ErikOostveen/PerfectBeat/images/20200609_163351.jpg

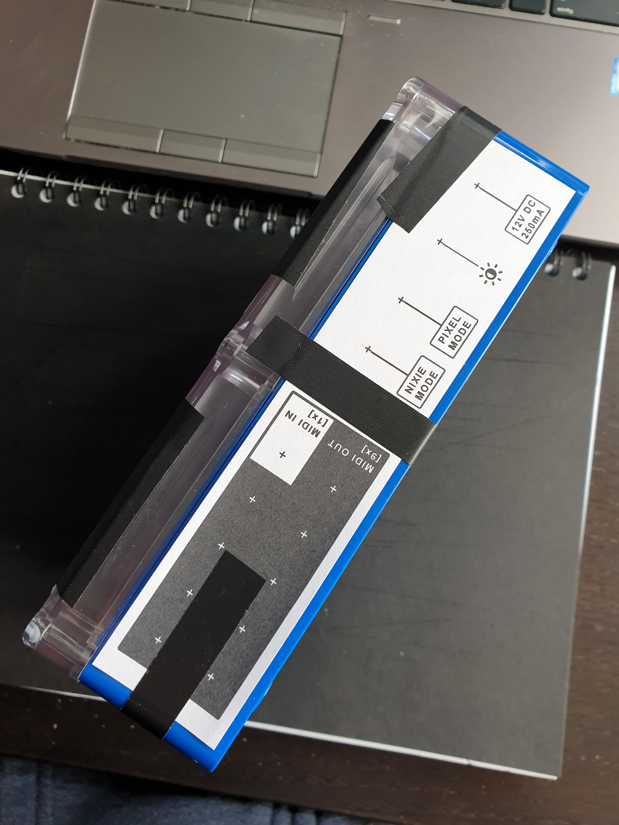
images/20200609_163351.jpg
