ErikOostveen/PerfectBeat/Diagram_PerfectBeat_V1.pdf

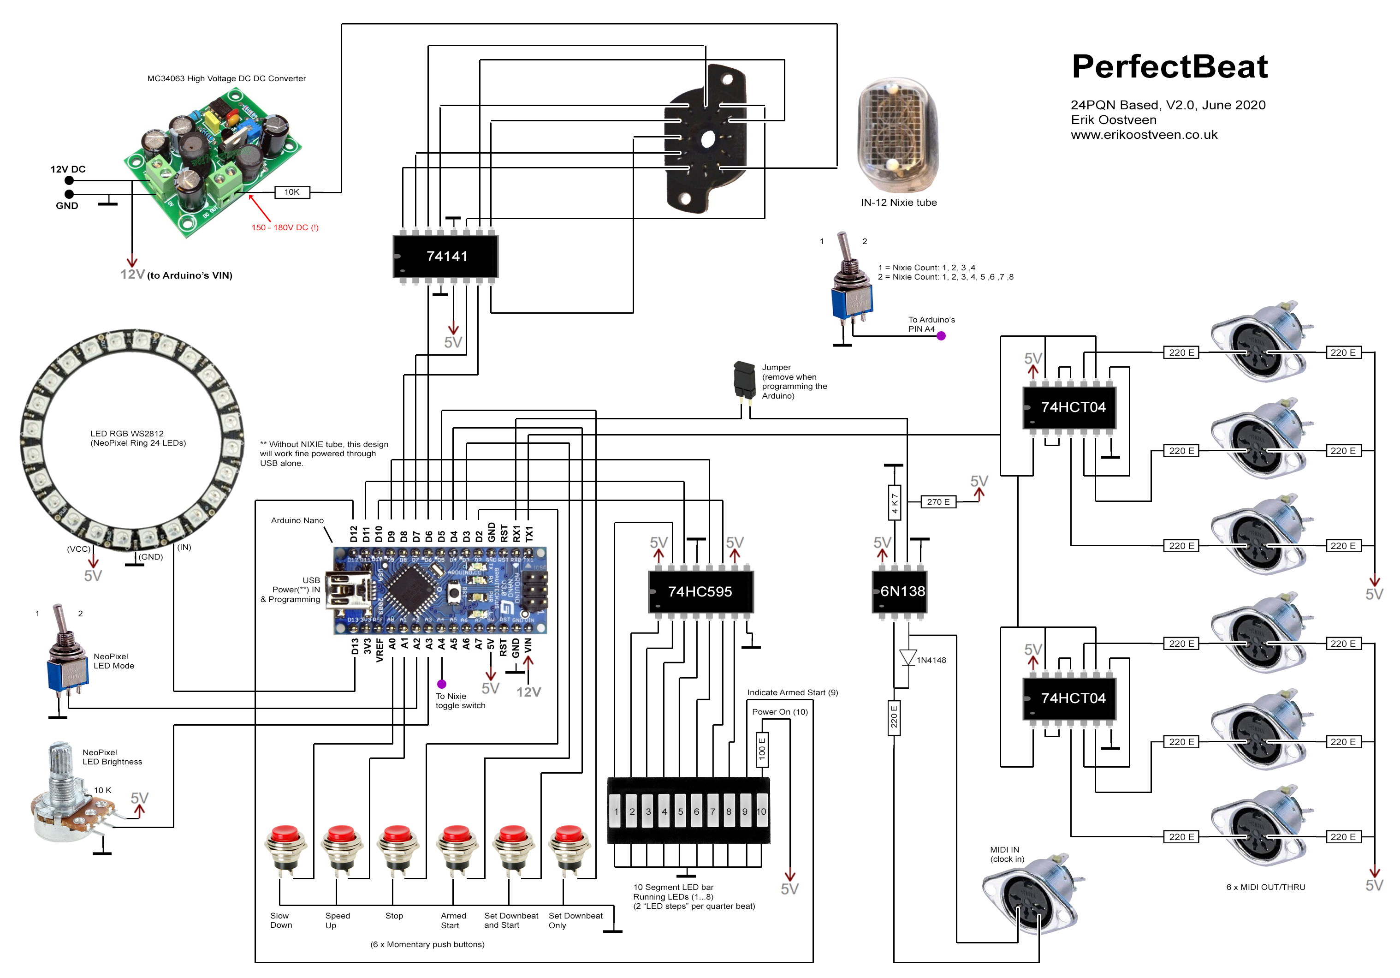
[picture p3: page 1]
