ErikOostveen/PerfectBeat/PerfectBeat_Front_V1_TEMPLATE_CUT_DRILL.pdf

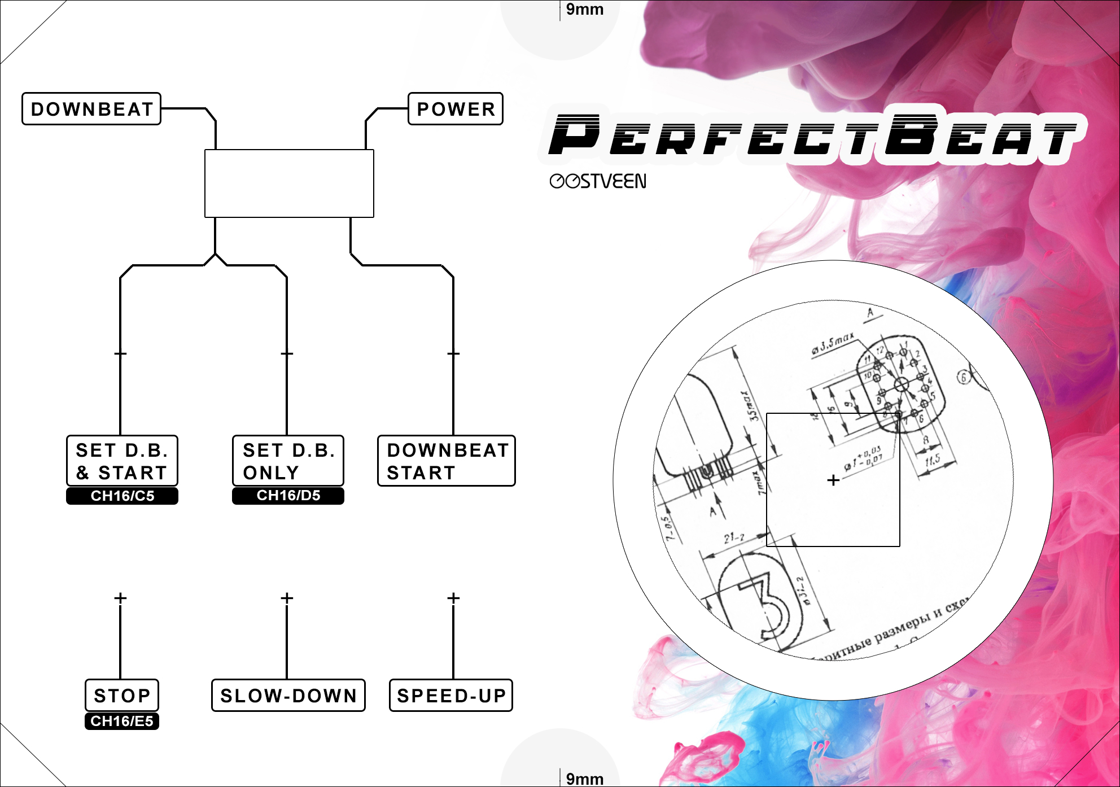
[picture p4: page 1]
