ErikOostveen/PerfectBeat/pcb/PerfectBeat_V1_PCB_Top_View.pdf

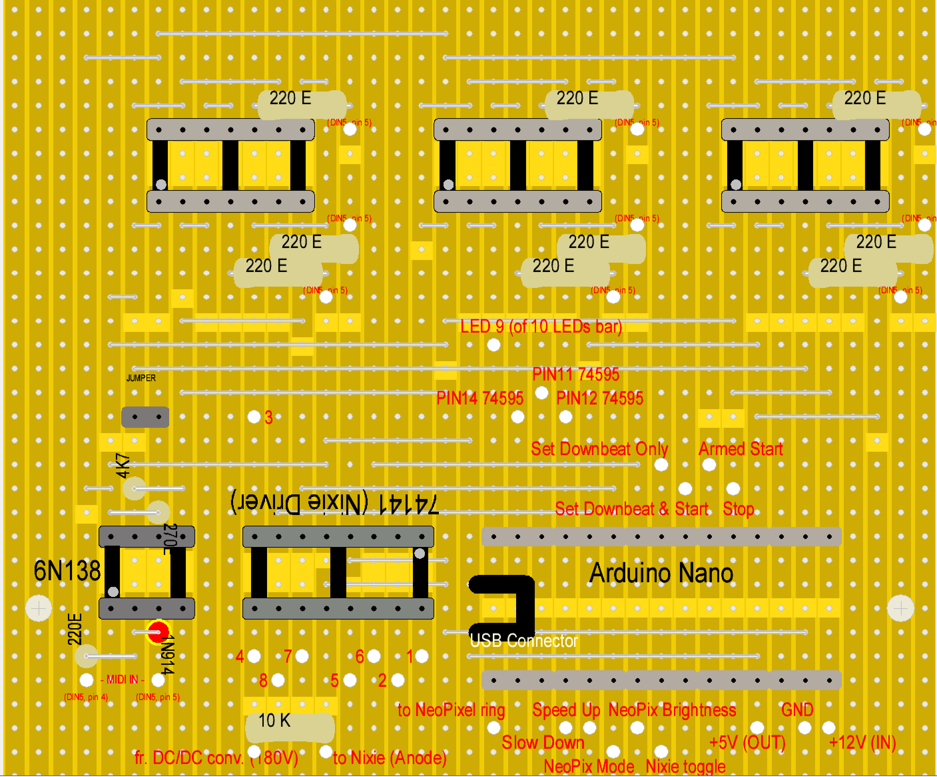
[picture p5: page 1]
