ErikOostveen/PerfectBeat/images/20200607_170726.jpg

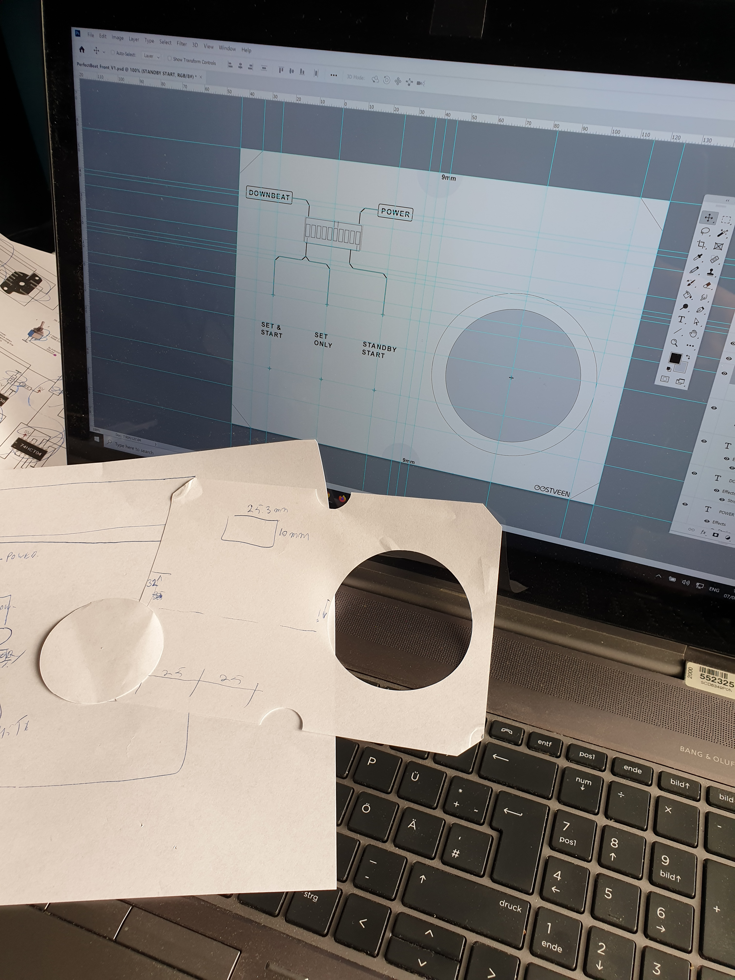
images/20200607_170726.jpg
