ErikOostveen/PerfectBeat/images/20200608_153944.jpg

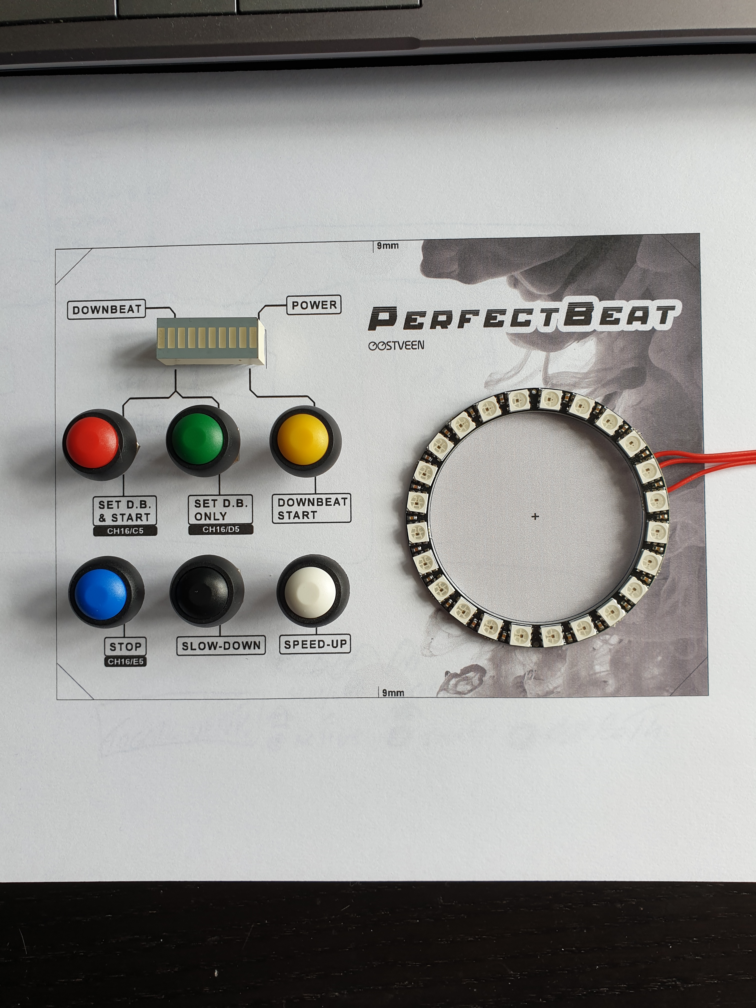
images/20200608_153944.jpg
