ErikOostveen/PerfectBeat/images/20200609_091026.jpg

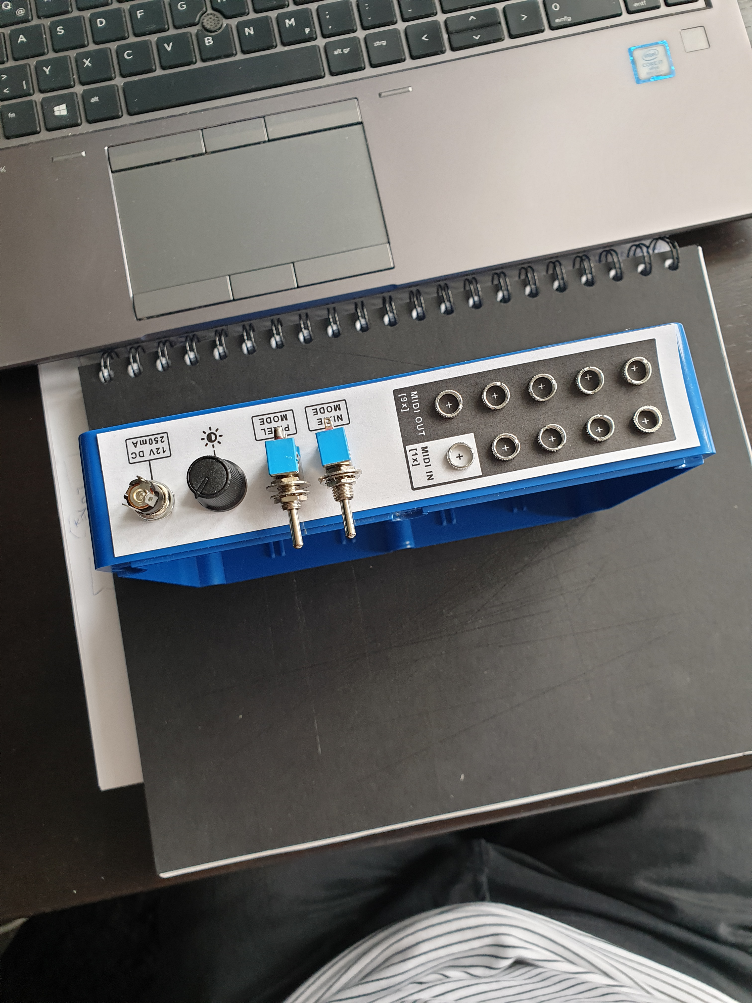
images/20200609_091026.jpg
