ErikOostveen/PerfectBeat/images/20200609_163342.jpg

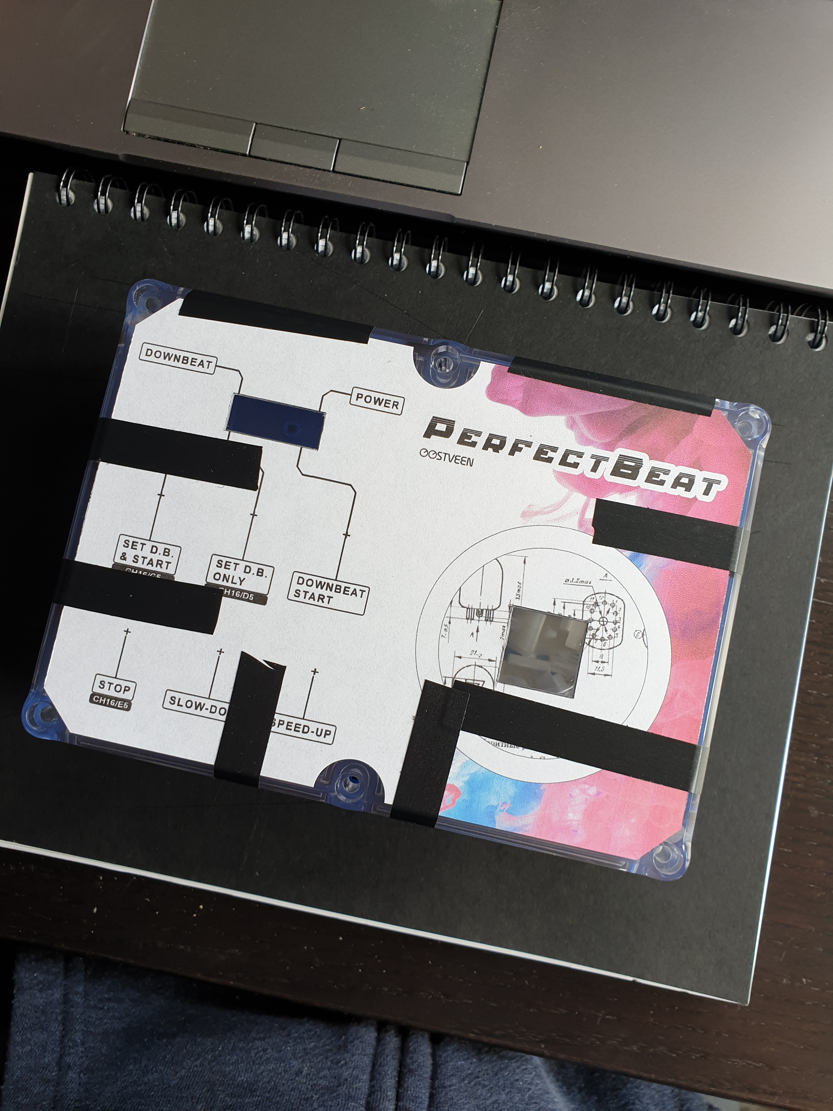
images/20200609_163342.jpg
