ErikOostveen/PerfectBeat/images/20200612_162909.jpg

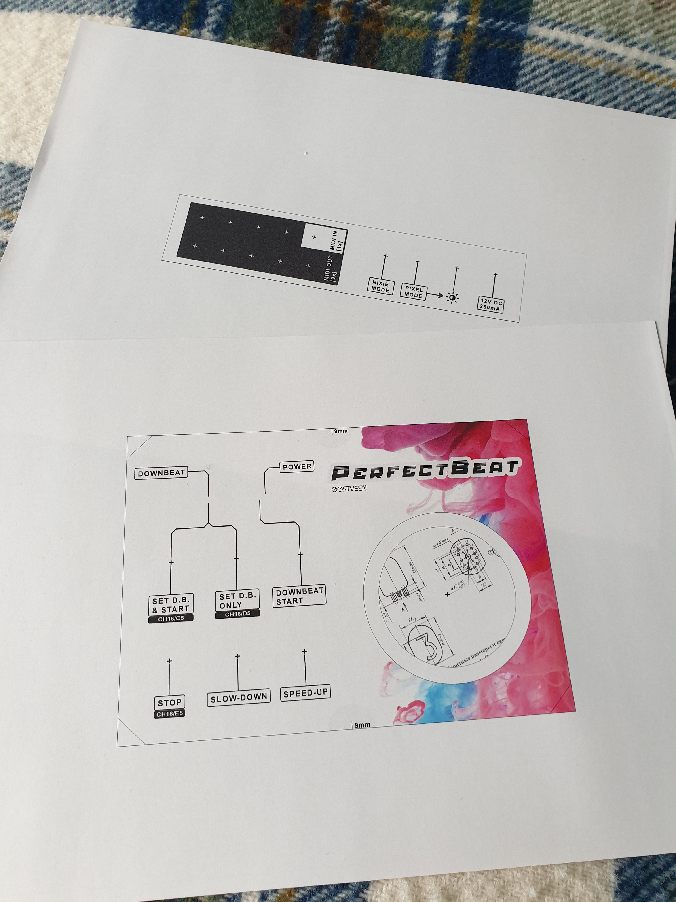
images/20200612_162909.jpg
