ErikOostveen/PerfectBeat/images/20200612_220927.jpg

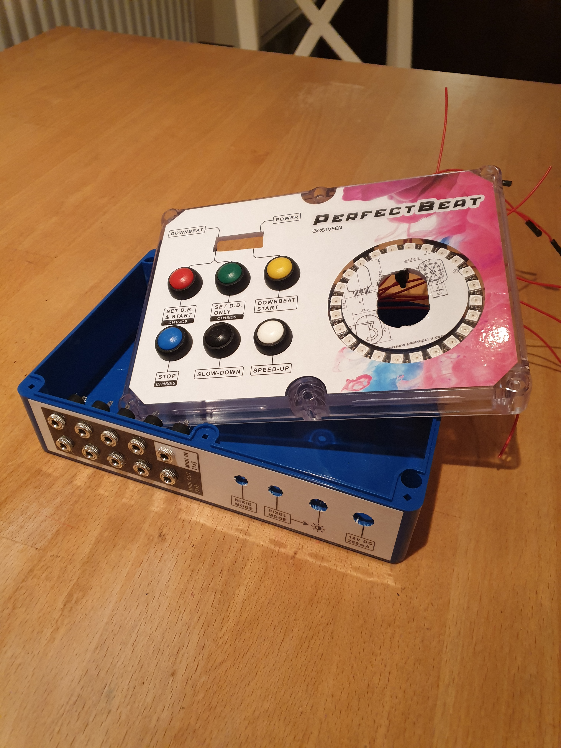
images/20200612_220927.jpg
