ErikOostveen/PerfectBeat/pcb/PerfectBeat_V1_PCB_Opposite_Side.PNG

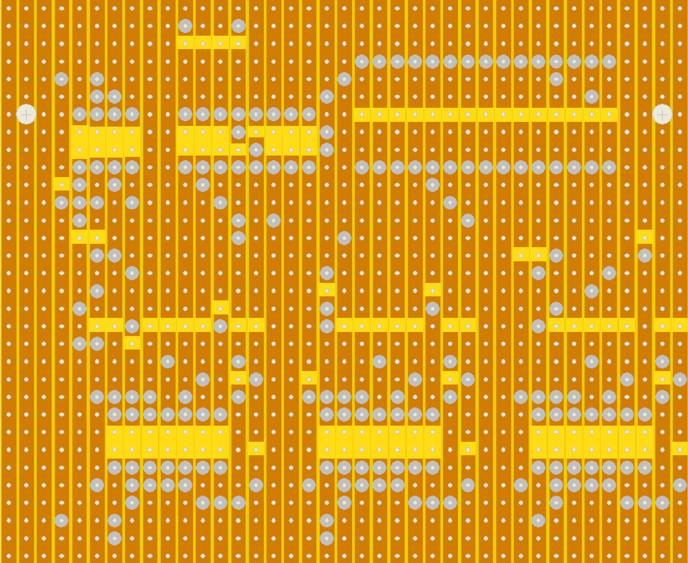
pcb/PerfectBeat_V1_PCB_Opposite_Side.PNG
