ErikOostveen/PerfectBeat/pcb/PerfectBeat_V1_PCB_Opposite_Side_See_Through.PNG

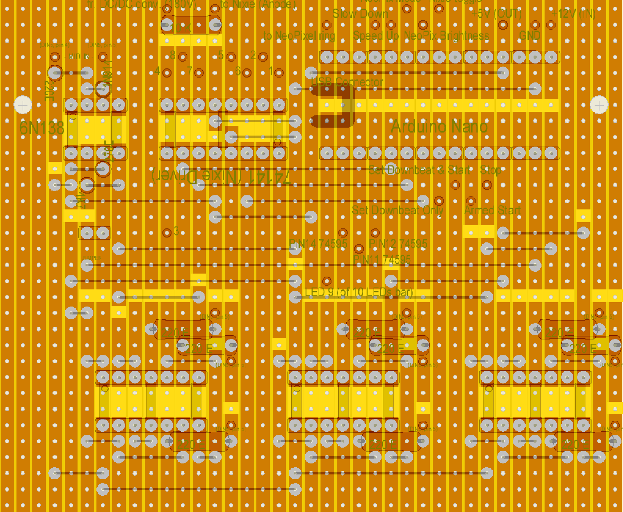
pcb/PerfectBeat_V1_PCB_Opposite_Side_See_Through.PNG
