ErikOostveen/PerfectBeat/PerfectBeat_Front_V1_FINAL_PRINT.pdf

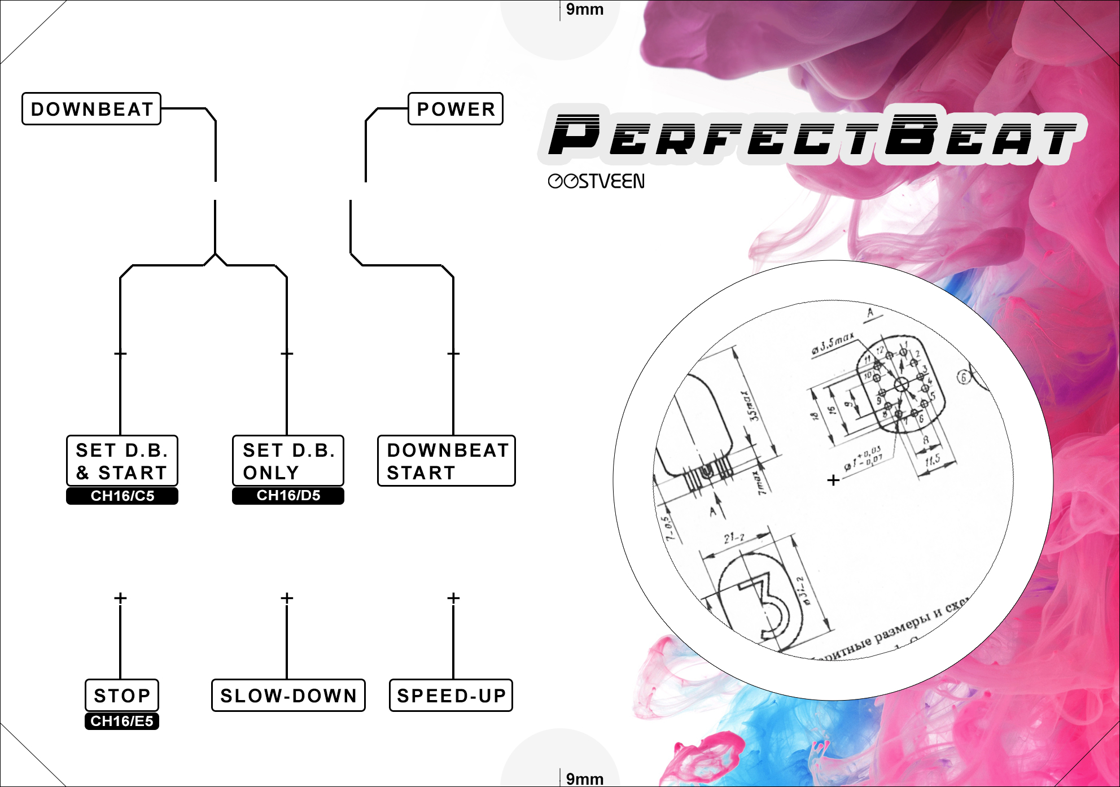
[picture p20: page 1]
