ErikOostveen/PerfectBeat/PerfectBeat_Rear_V1_TEMPLATE_DRILL_AND_FINAL_PRINT.pdf

++

++

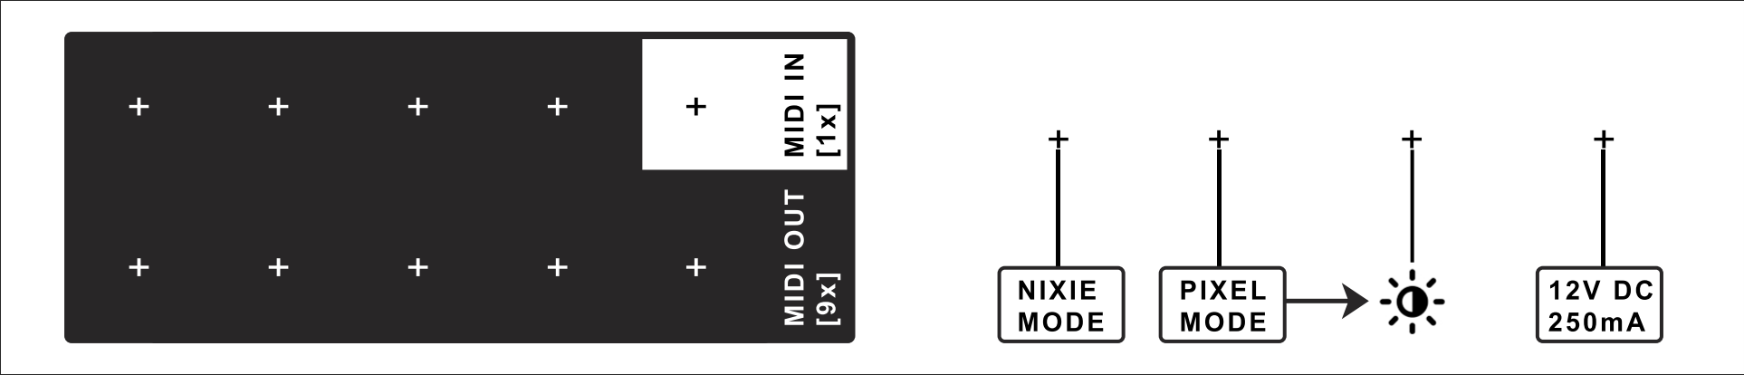
[picture p21: page 1]

MIDIIN
[1x]

MIDIOUT

[9x]

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
