ErikOostveen/PerfectBeat/images/20200604_204954.jpg

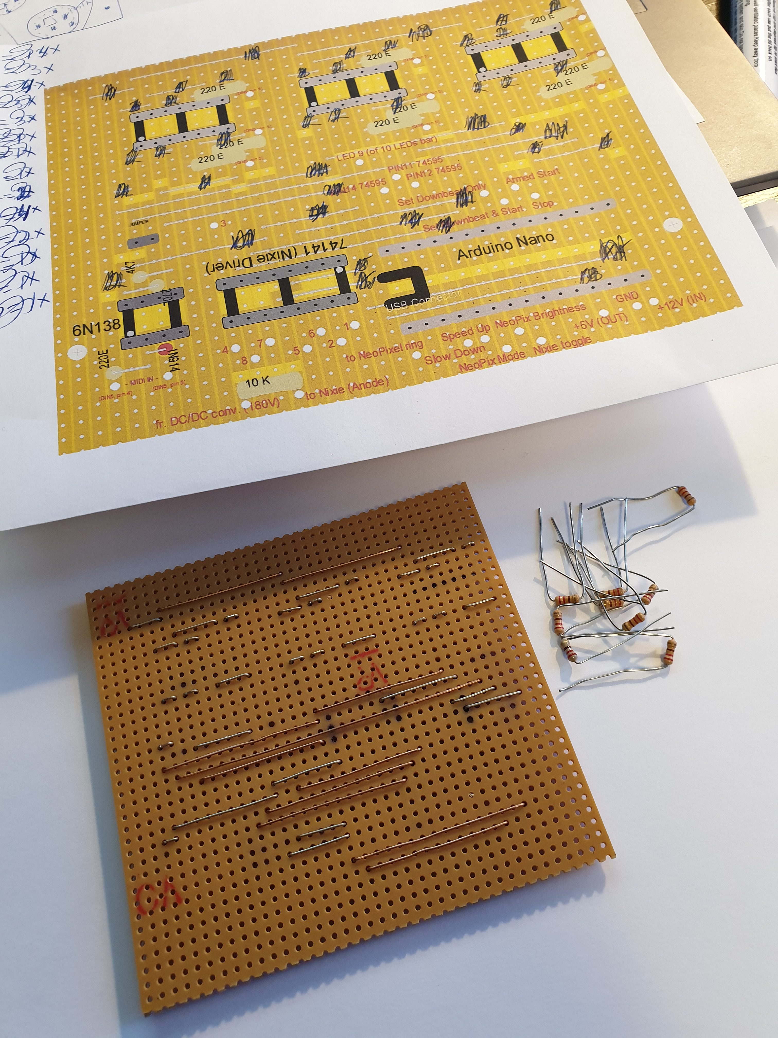
images/20200604_204954.jpg
