ErikOostveen/PerfectBeat/images/20200604_220543.jpg

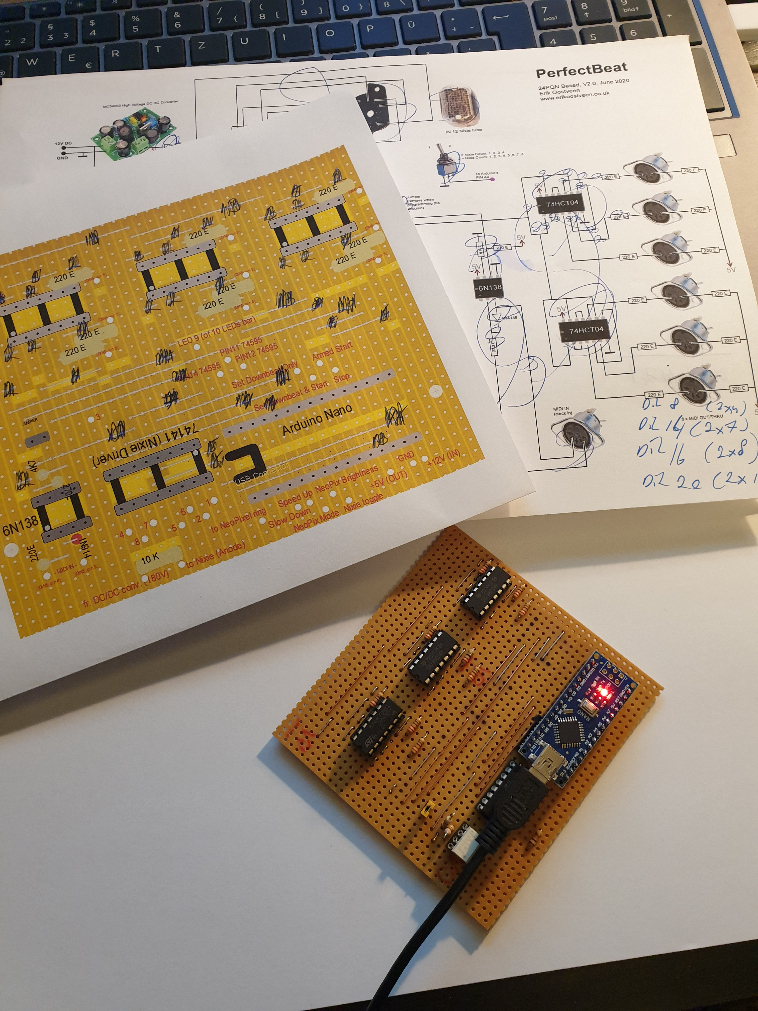
images/20200604_220543.jpg
