ErikOostveen/PerfectBeat/images/20200606_164817.jpg

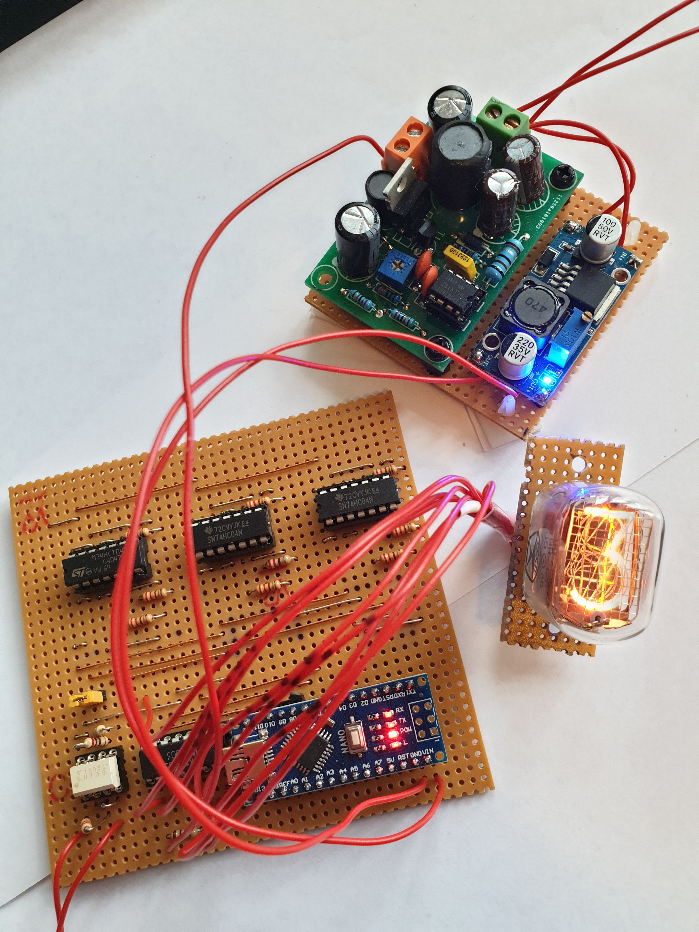
images/20200606_164817.jpg
