ErikOostveen/PerfectBeat/images/20200613_112246.jpg

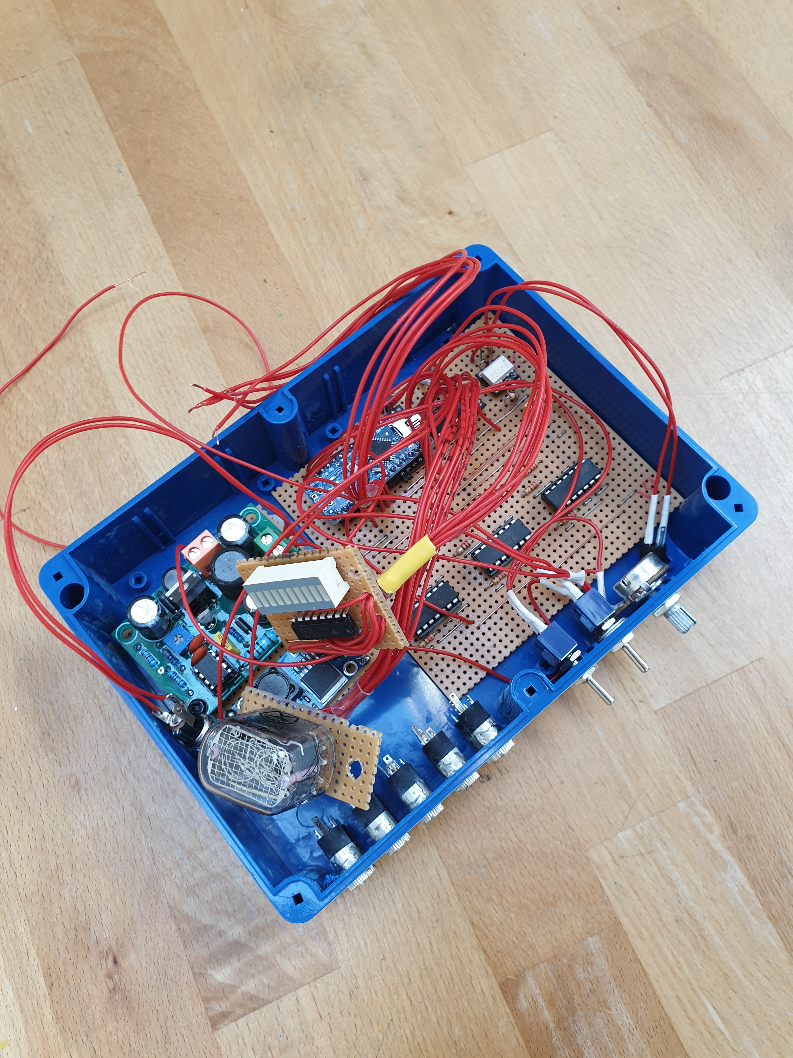
images/20200613_112246.jpg
