ErikOostveen/PerfectBeat/images/20200613_112252.jpg

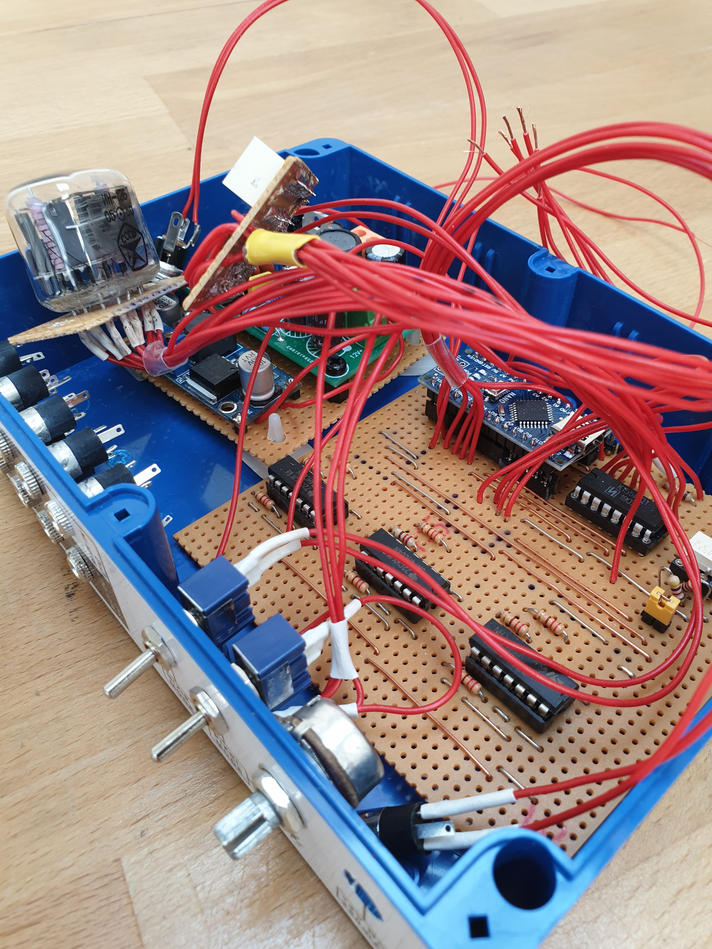
images/20200613_112252.jpg
