ErikOostveen/PerfectBeat/images/Main.jpg

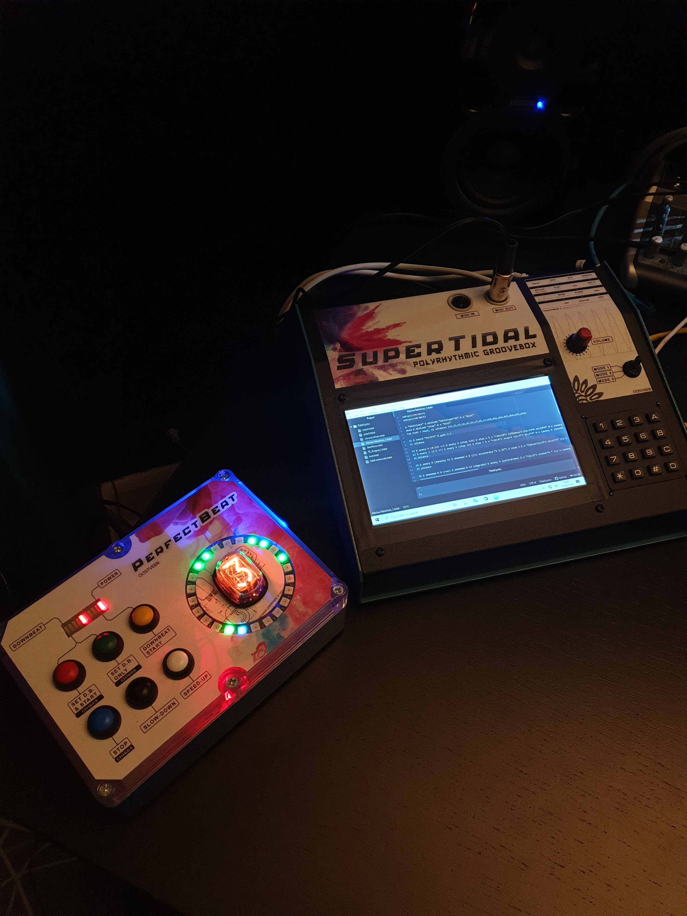
images/Main.jpg
