ErikOostveen/PerfectBeat/images/20200613_172004.jpg

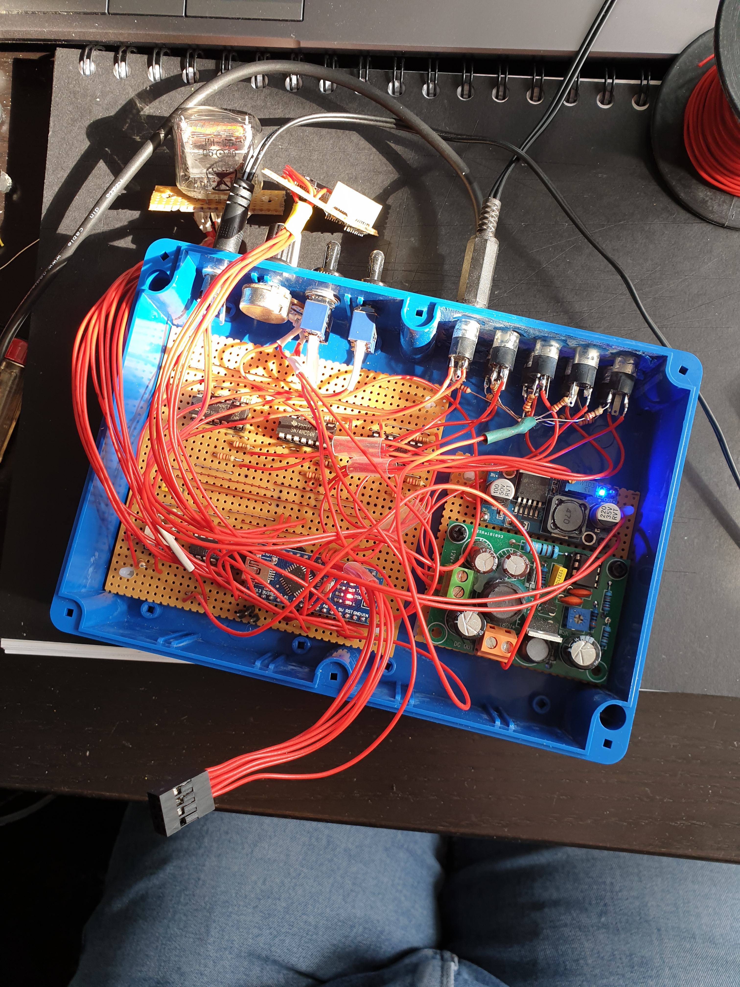
images/20200613_172004.jpg
